tunahandv/sismoev/app/README.md

# Web app (Flutter Web)

Live device status and event history, read from the MQTT broker over secure WebSocket.
Hosted on Firebase Hosting and added to the iPhone home screen. Planned for Week 11.
