tunahandv/sismoev/docs/wiring_en.png

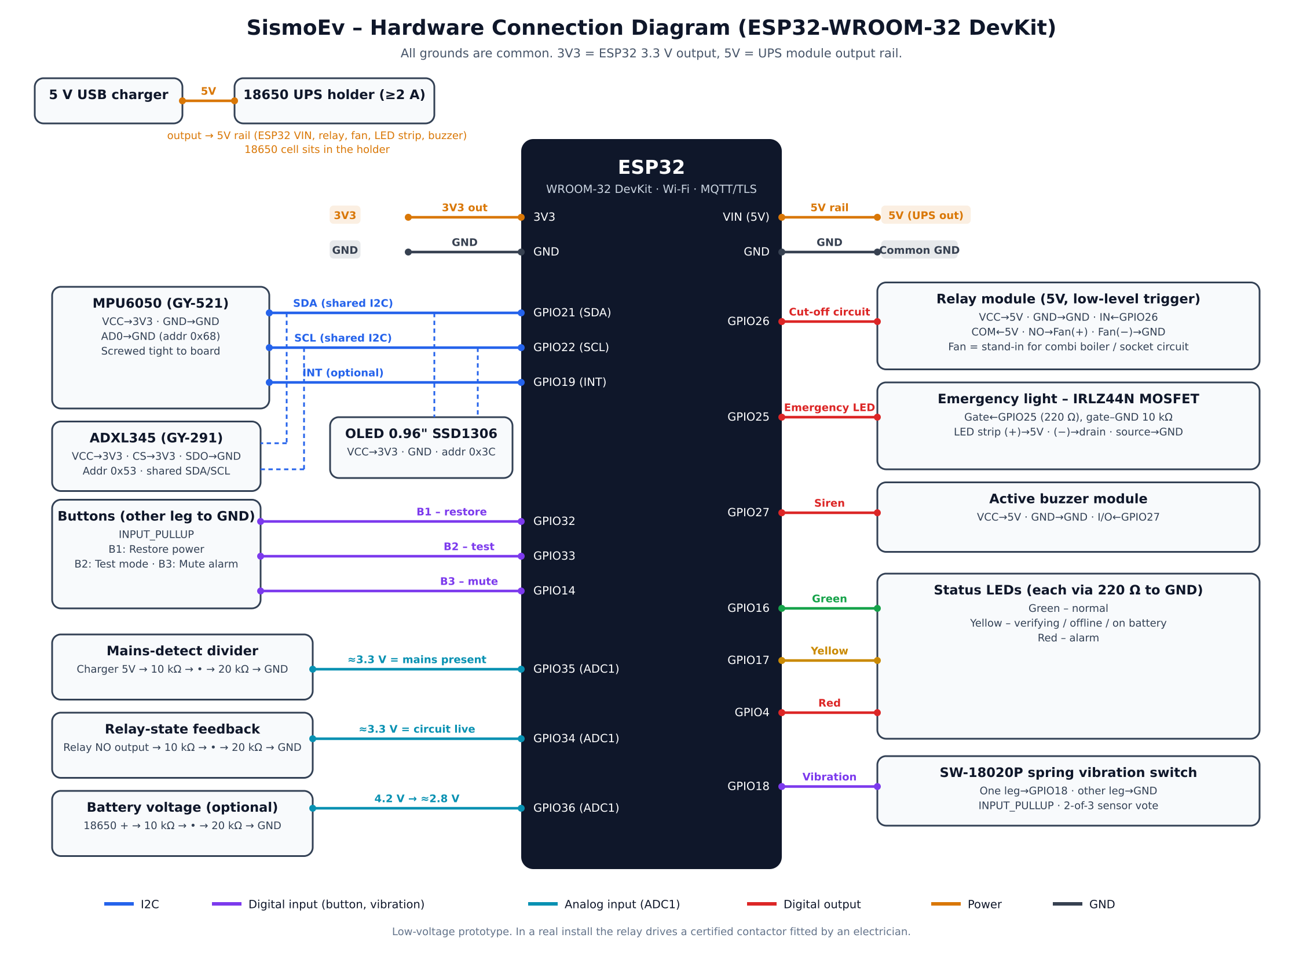
docs/wiring_en.png
