tunahandv/sismoev/(commit log)

2026-11-09 Initial project structure: docs, pin plan, demo plan, I2C scanner test
    Claude-Session: https://claude.ai/code/session_01LE7RLeFciawSAHxcxd7XXd
2026-11-10 Add output test: LEDs, buttons, buzzer, relay
    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
    [outputs_test.ino]
2026-11-11 Drive the relay through an IRLZ44N MOSFET; add relay test
    The low-level relay module stayed on when driven directly from the
    ESP32's 3.3 V pin. A MOSFET now pulls IN low on HIGH and releases it on LOW.
    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
2026-11-12 Add OLED + vibration switch test
    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
    [oled_switch_test.ino]
2026-11-12 OLED test: check that the screen answers on I2C before reporting OK
    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
2026-11-12 Switch test: report each shake/knock as a separate event with hit count and duration
    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
2026-11-12 Switch test: drop interrupt pause, print pin state at start
    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
2026-11-12 Detection notes: spring switch is a bonus vote, accelerometers decide
    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
2026-11-12 Add full test: LEDs, buttons, relay, buzzer and spring switch together
    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
    [full_test.ino]
